pylotylo/UW-ENGINE2023-Acoustic-Beamforming-Device/README.md

# UW-ENGINE2023-Acoustic-Beamforming-Device
This is a repository for the UW ENGINE 2023 Acoustic Beamforming Device team. Here we can share drafts of our Kicad files, and any other code related to the project.
