pylotylo/UW-ENGINE2023-Acoustic-Beamforming-Device/PCM1690 Breakout Board Draft 7/PCM1690 Breakout Board Draft 8.kicad_pcb

## KiCad design PCM1690 Breakout Board Draft 7/PCM1690 Breakout Board Draft 8.kicad_pcb (2023-03-06)

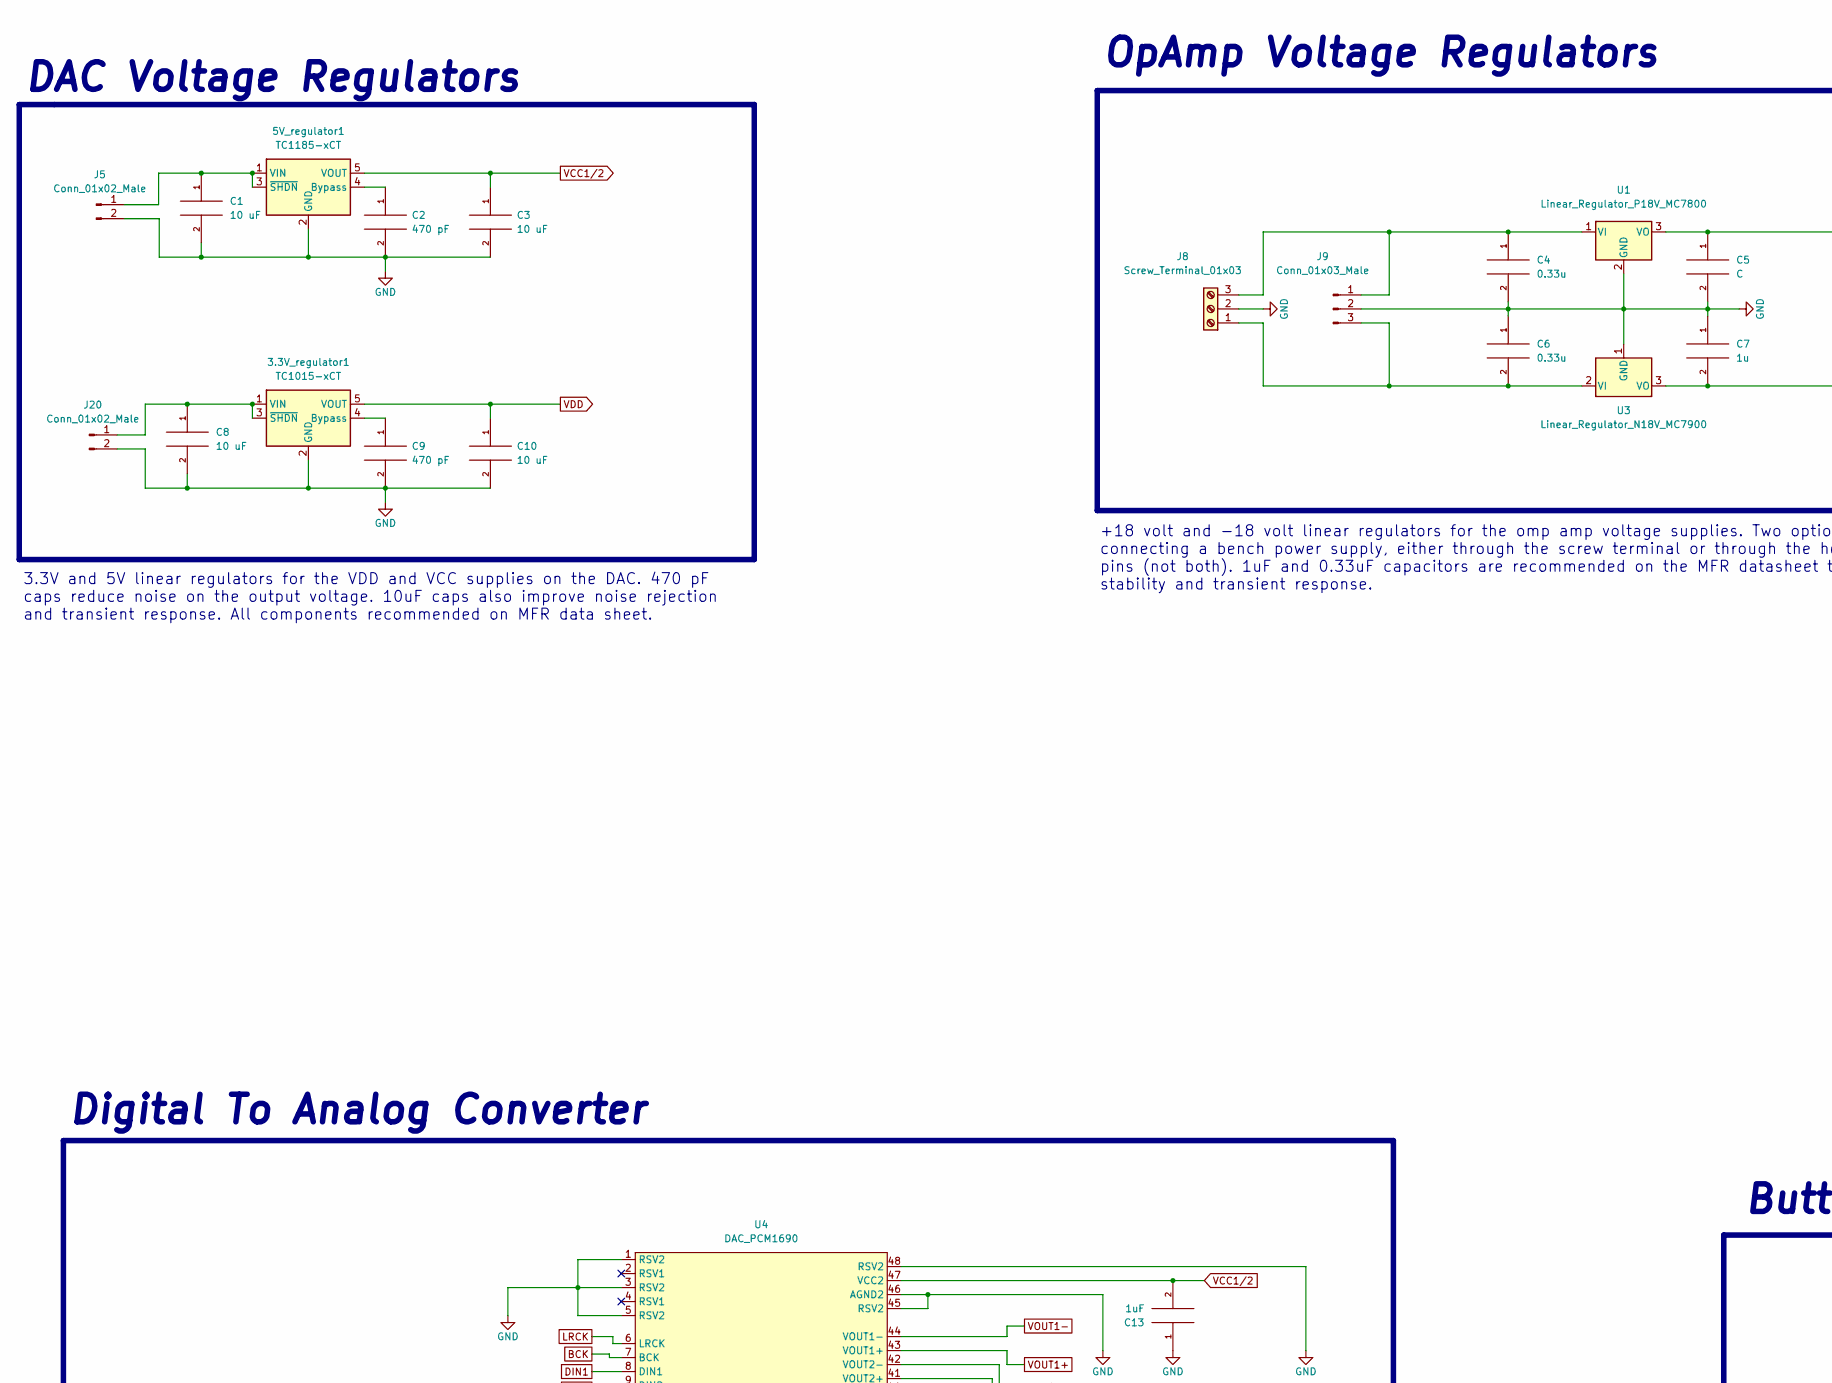
[picture p2: schematic PCM1690 Breakout Board Draft 8.kicad_sch, part in row 1, column 1]

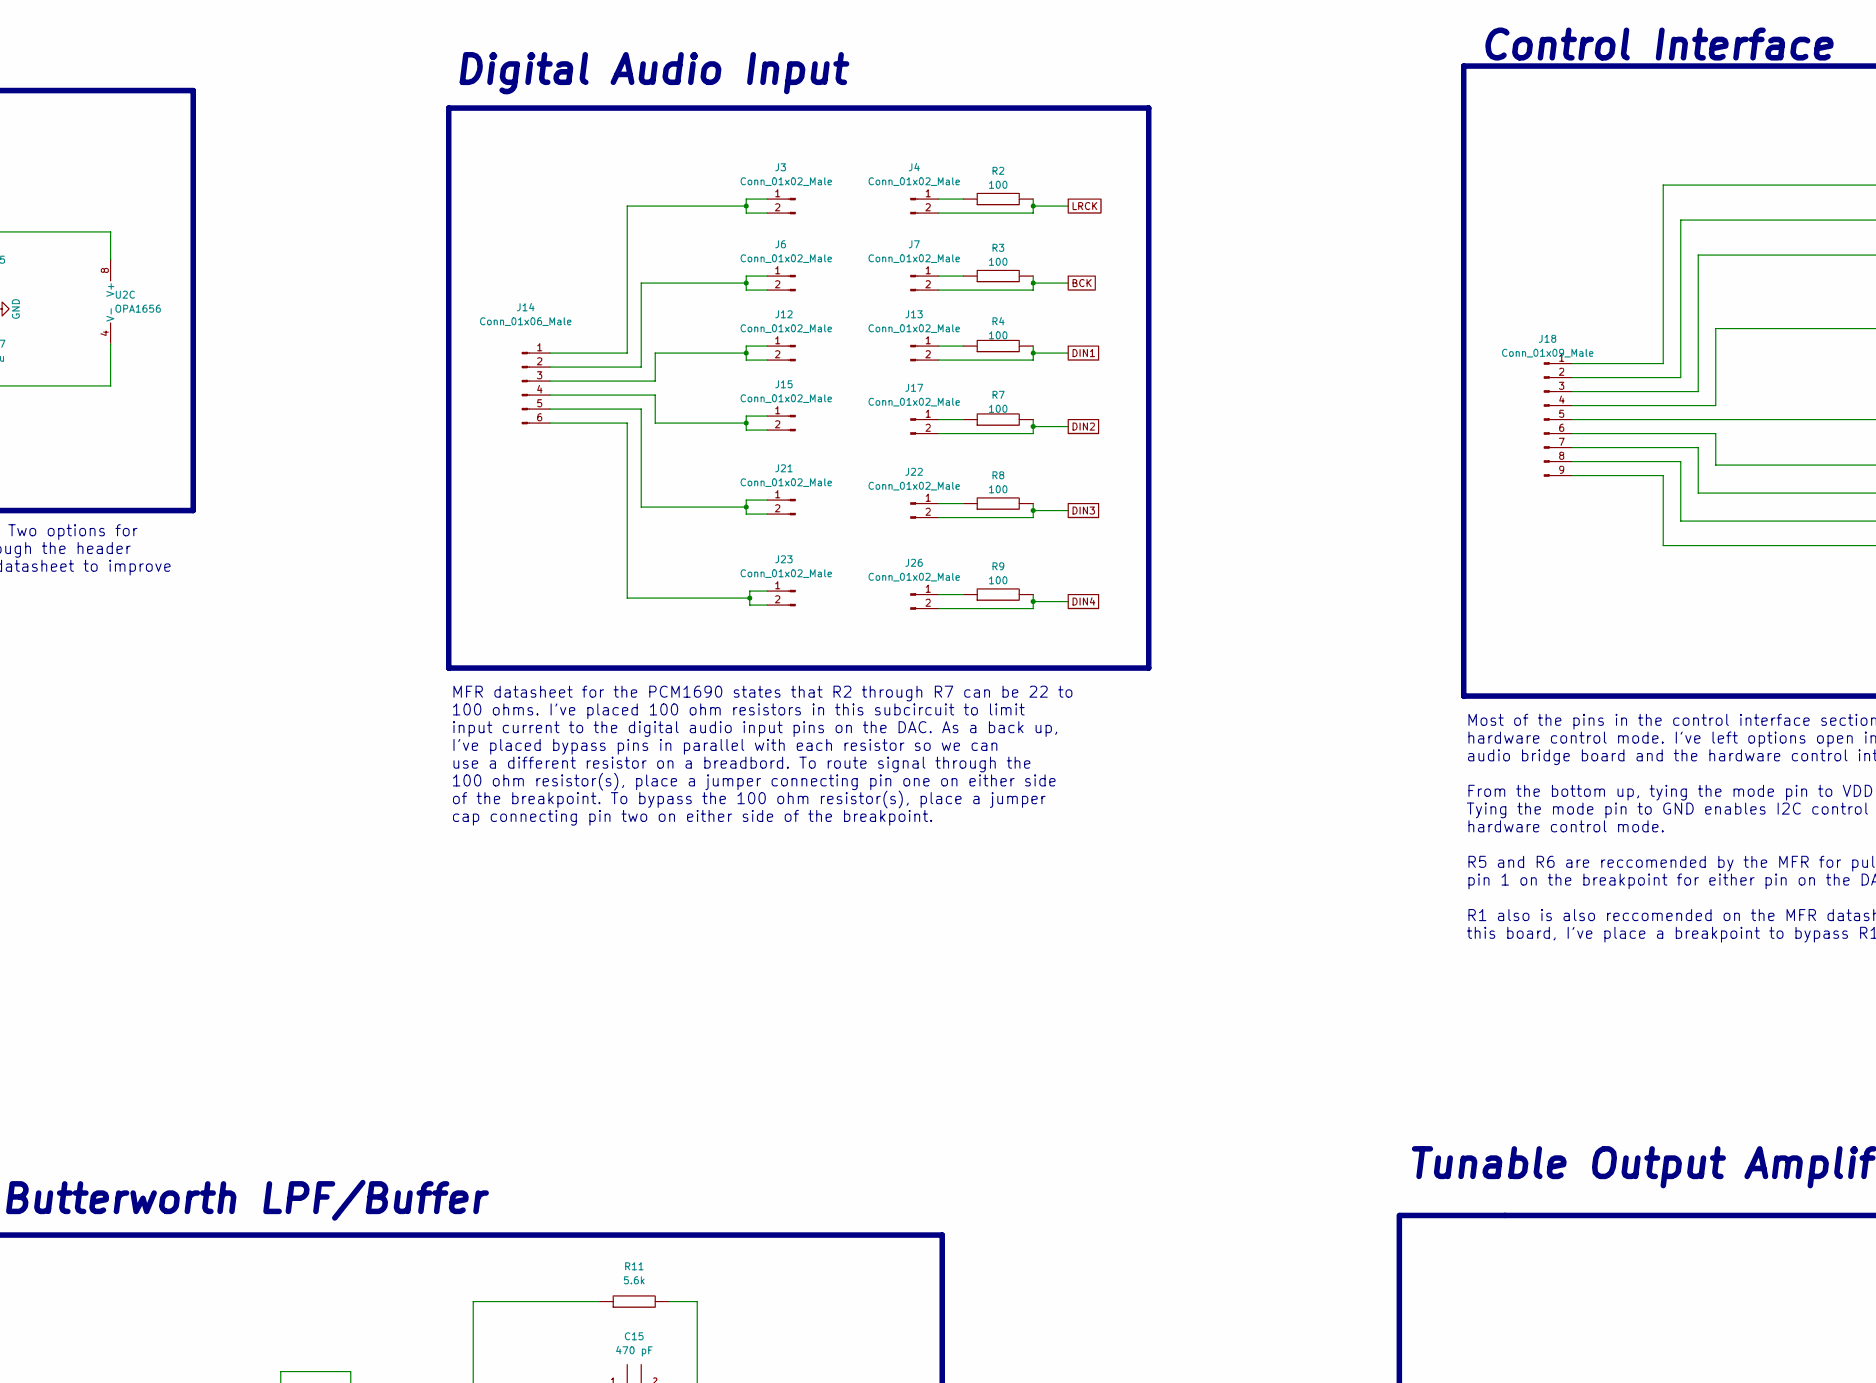
[picture p3: schematic PCM1690 Breakout Board Draft 8.kicad_sch, part in row 1, column 2]

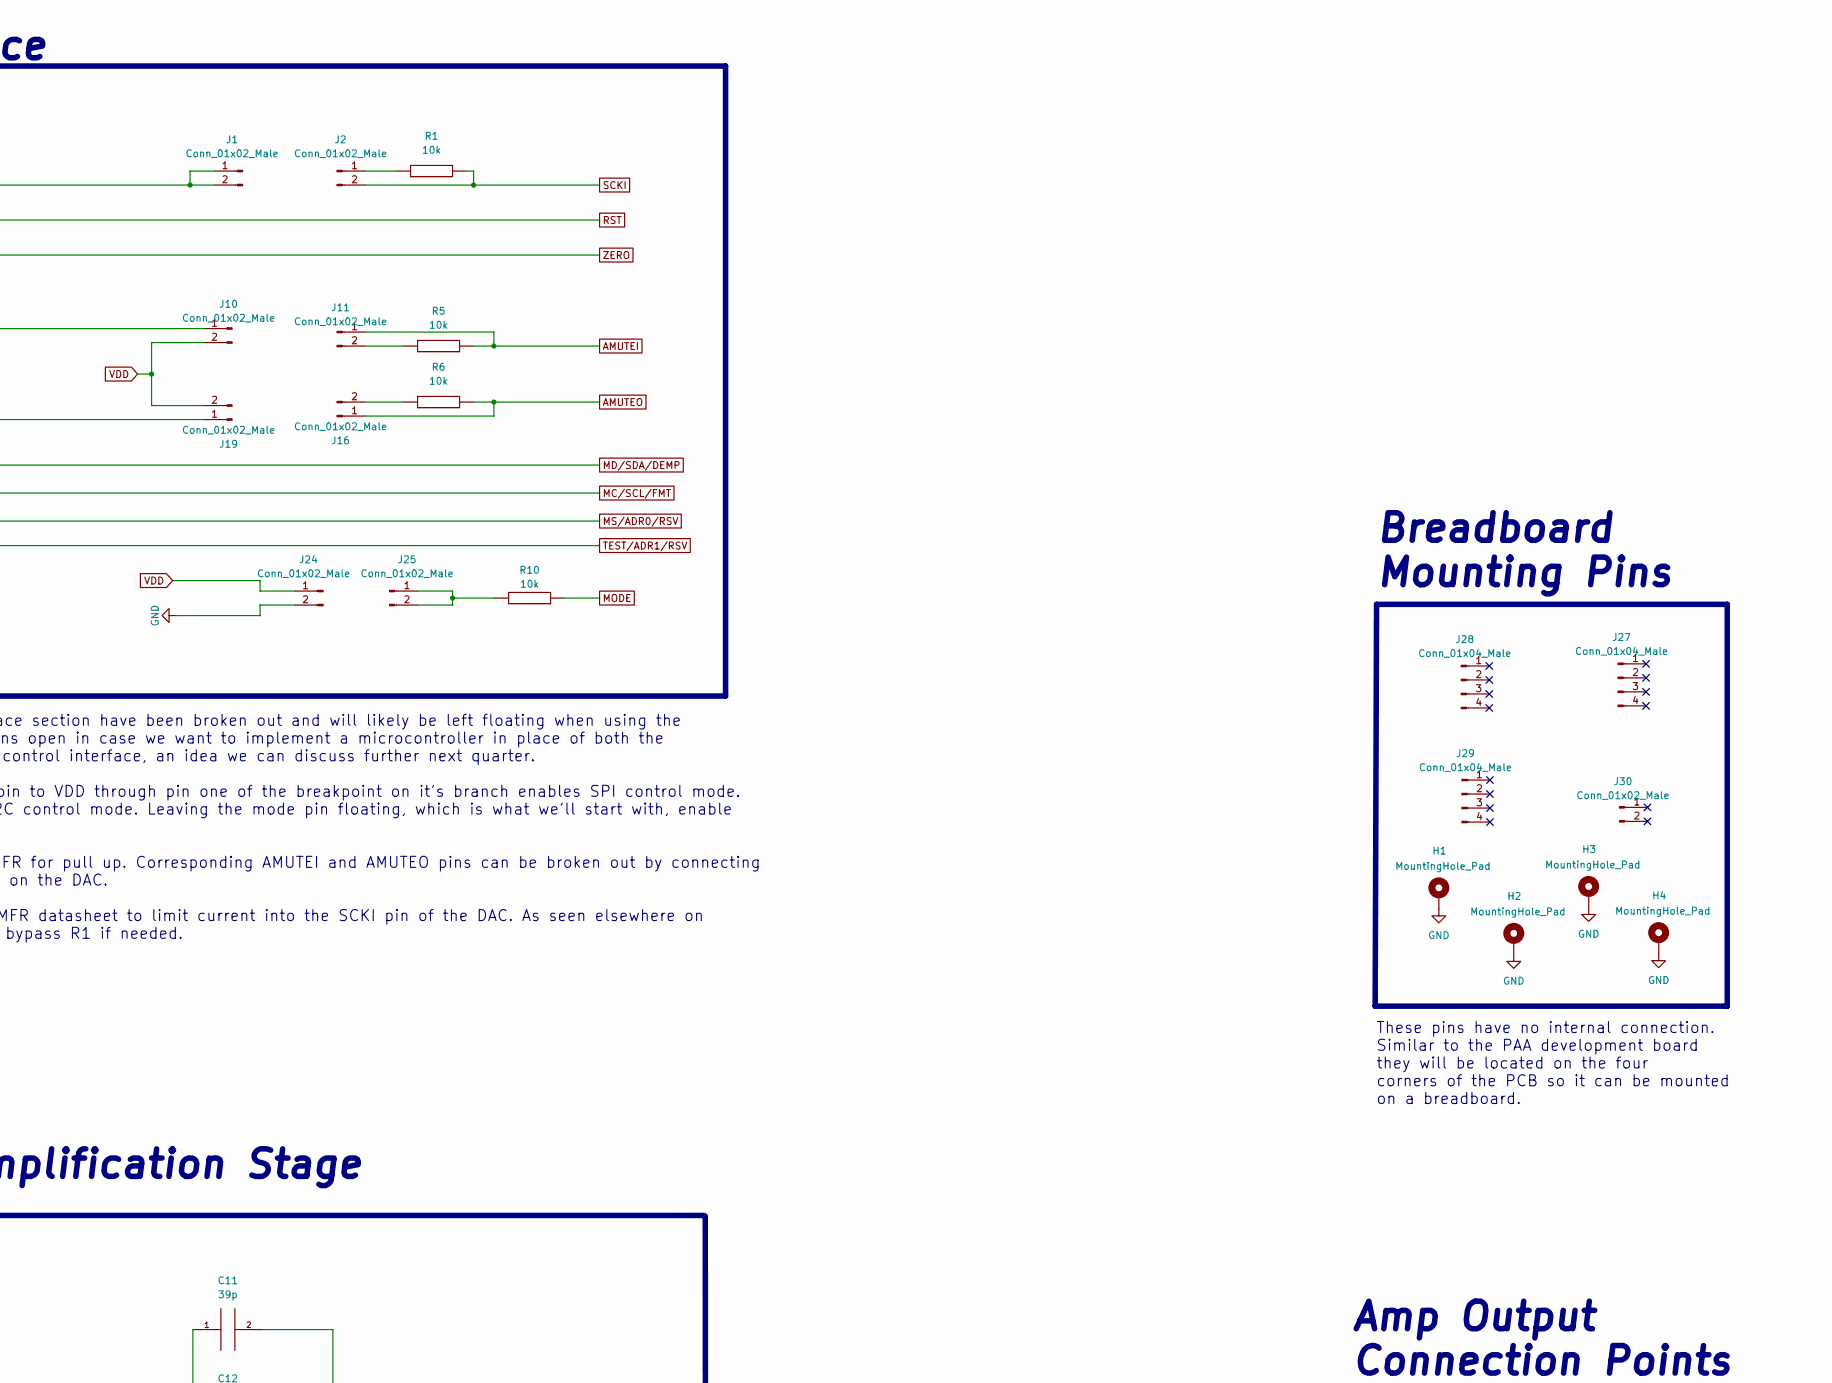
[picture p4: schematic PCM1690 Breakout Board Draft 8.kicad_sch, part in row 1, column 3]

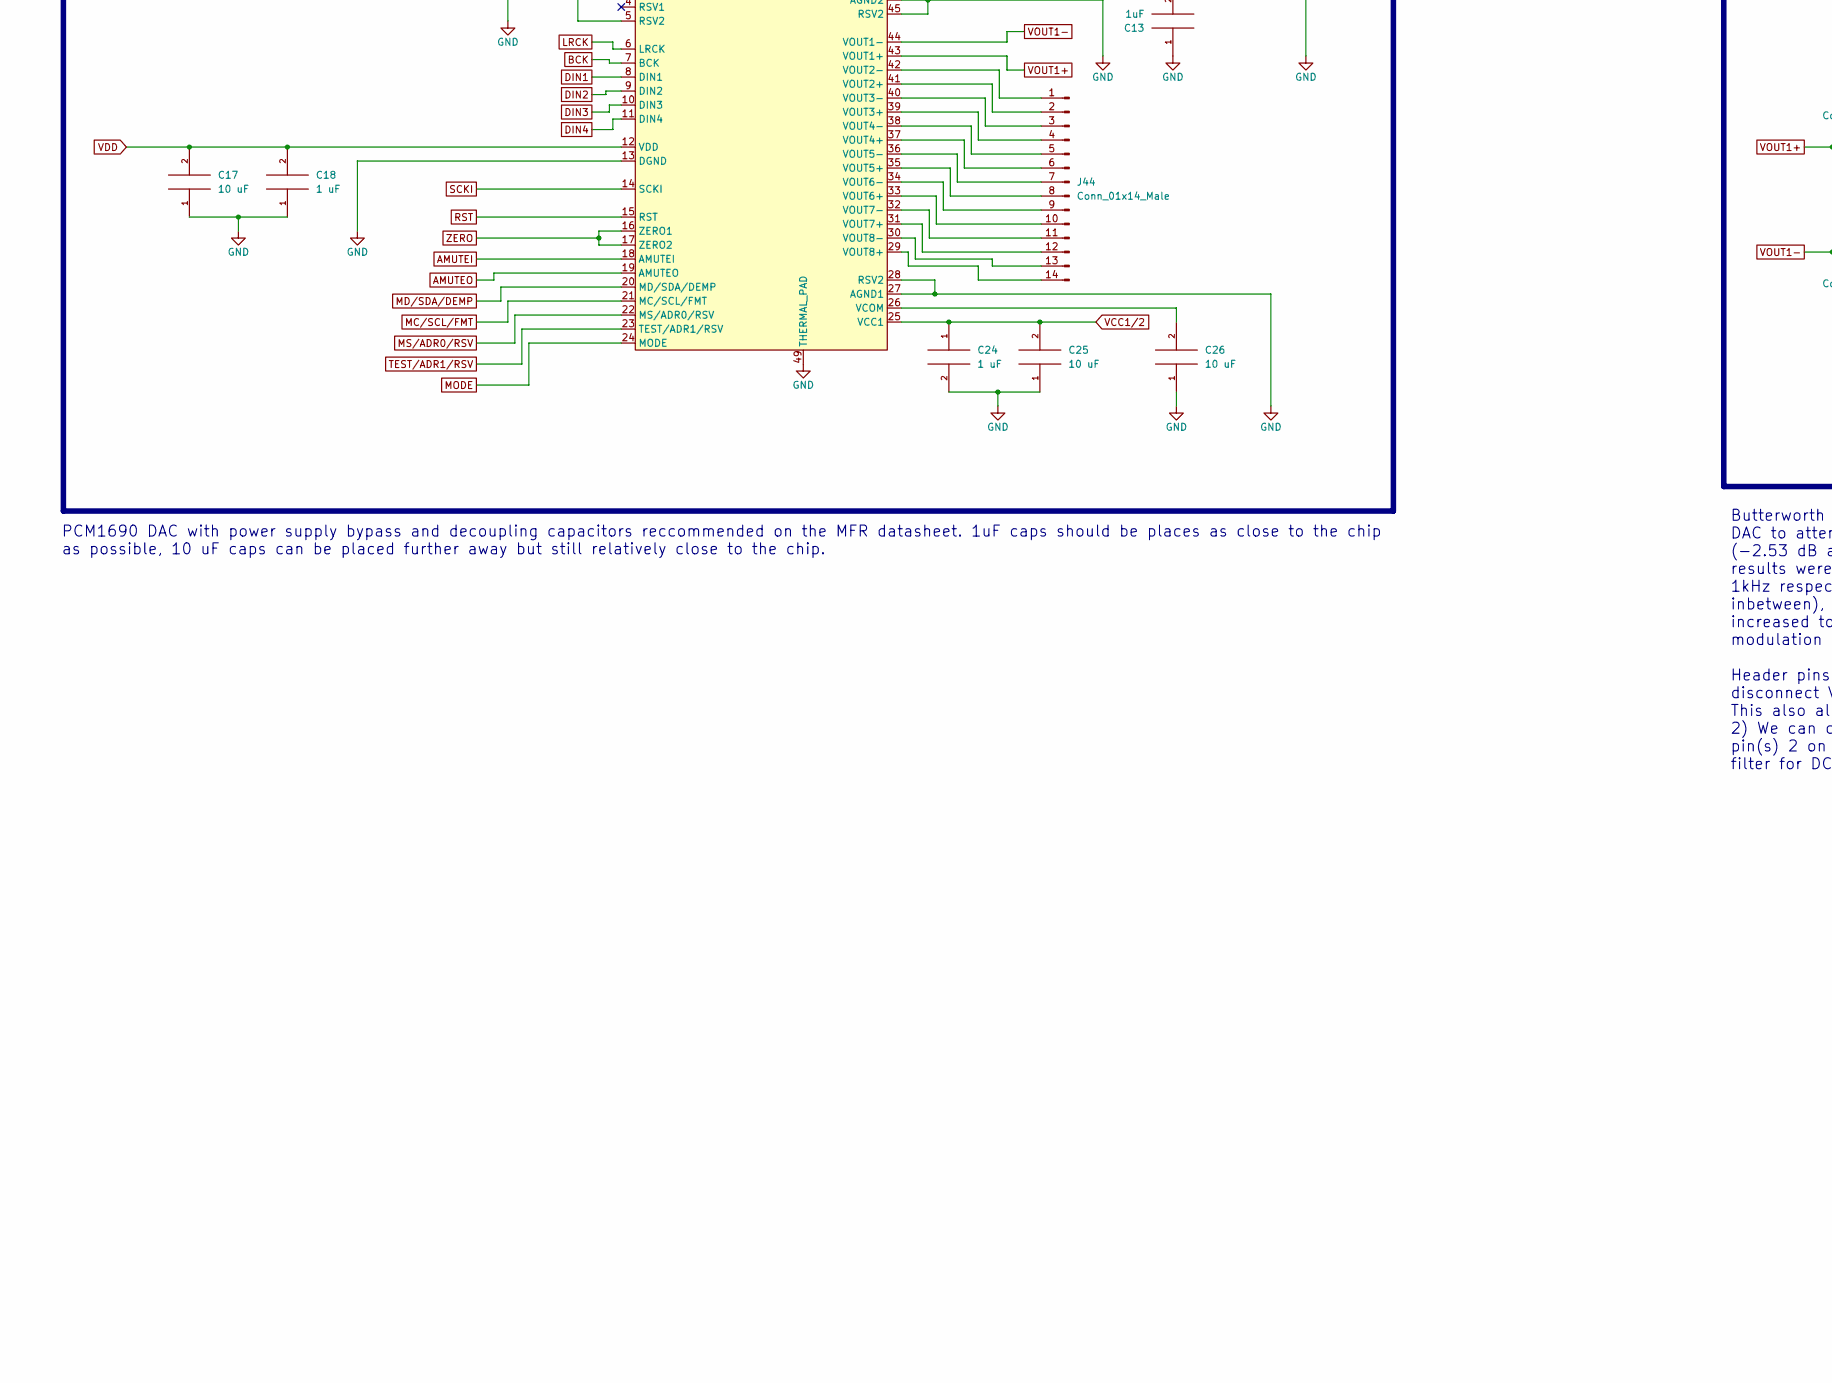
[picture p5: schematic PCM1690 Breakout Board Draft 8.kicad_sch, part in row 2, column 1]

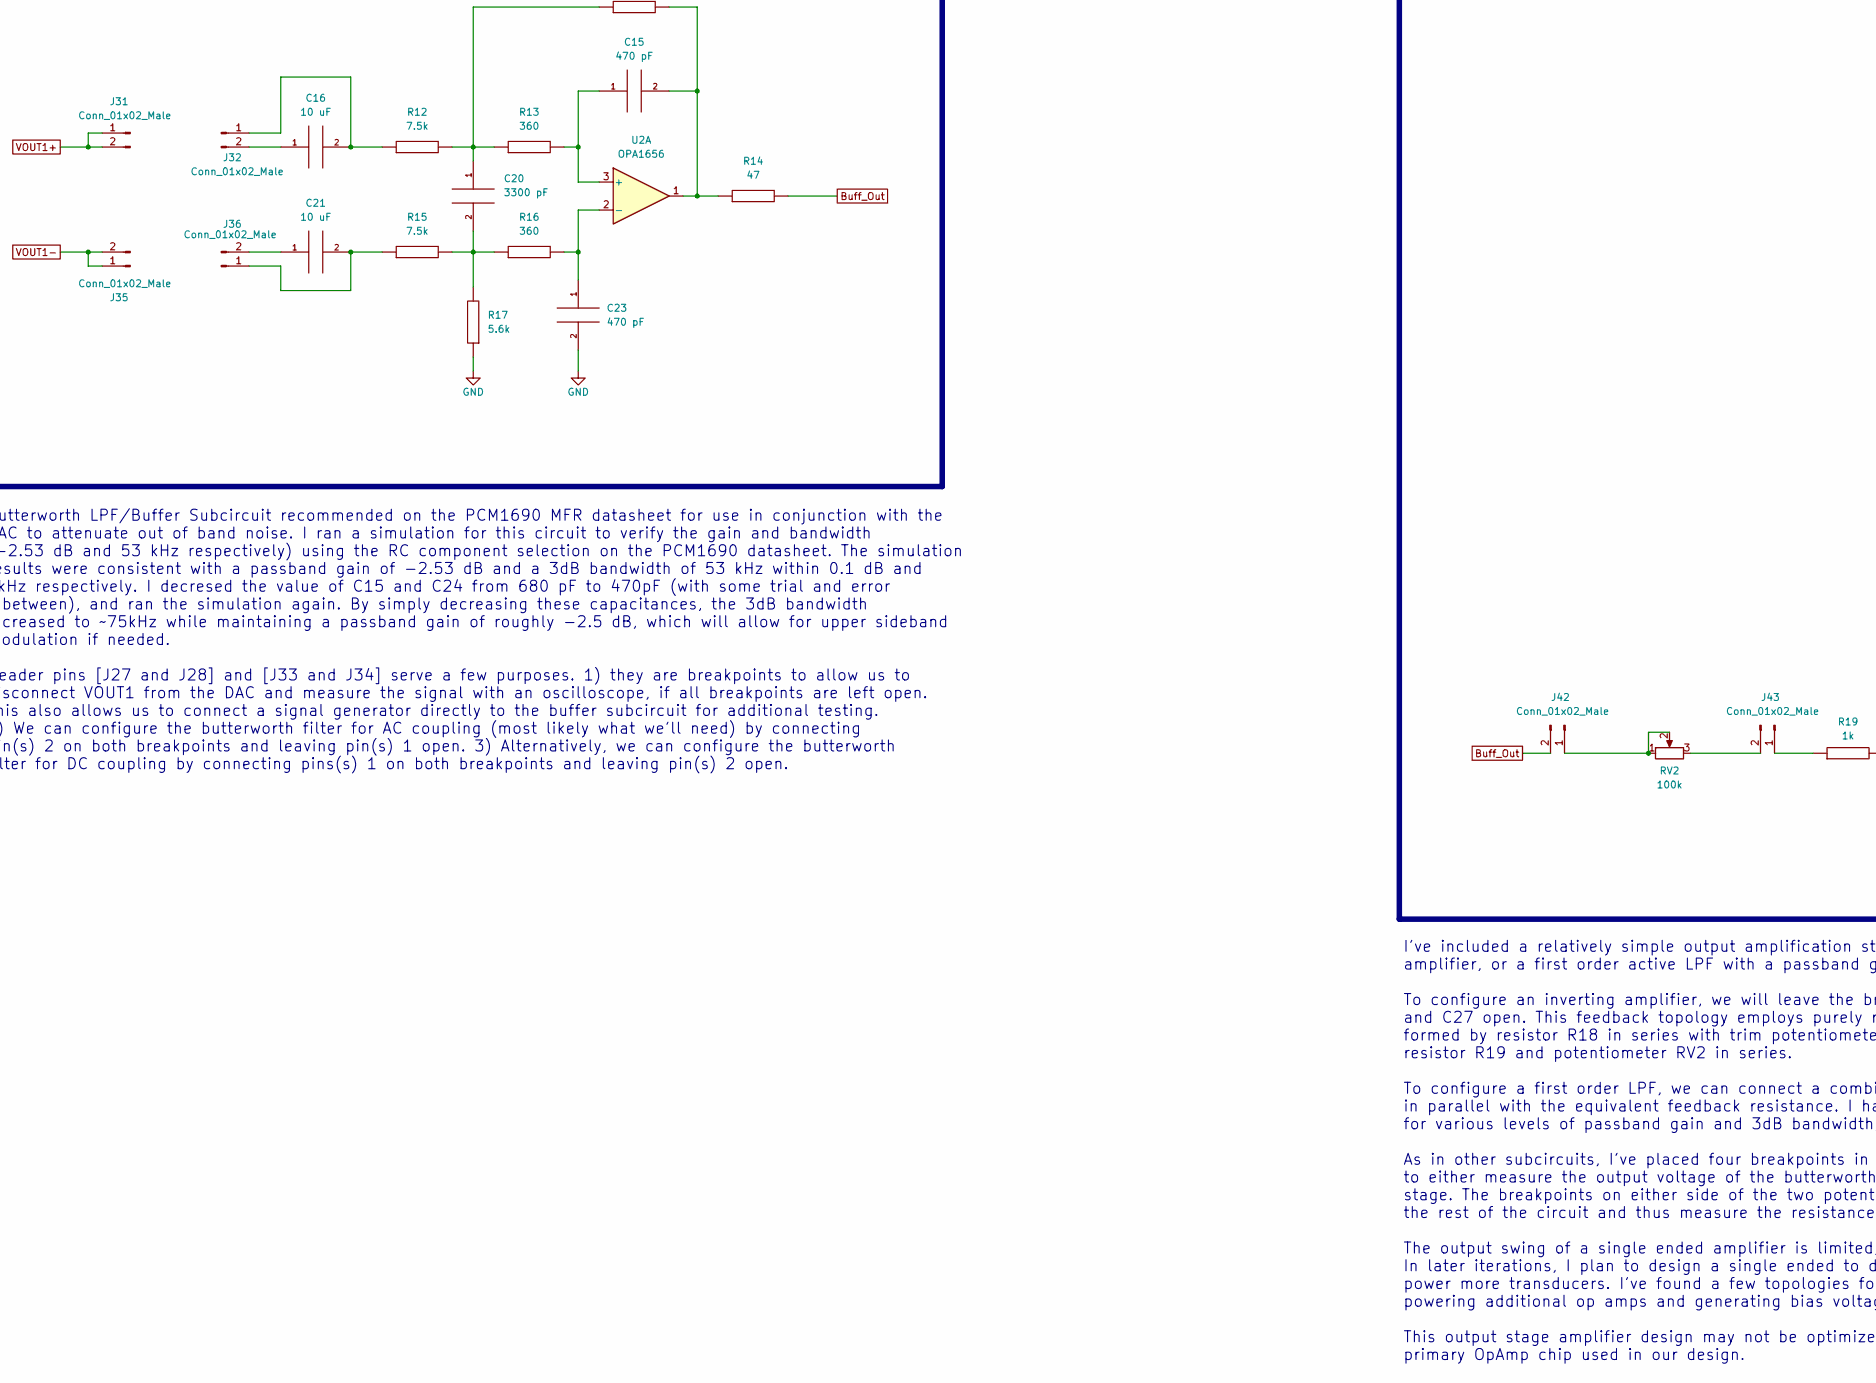
[picture p6: schematic PCM1690 Breakout Board Draft 8.kicad_sch, part in row 2, column 2]

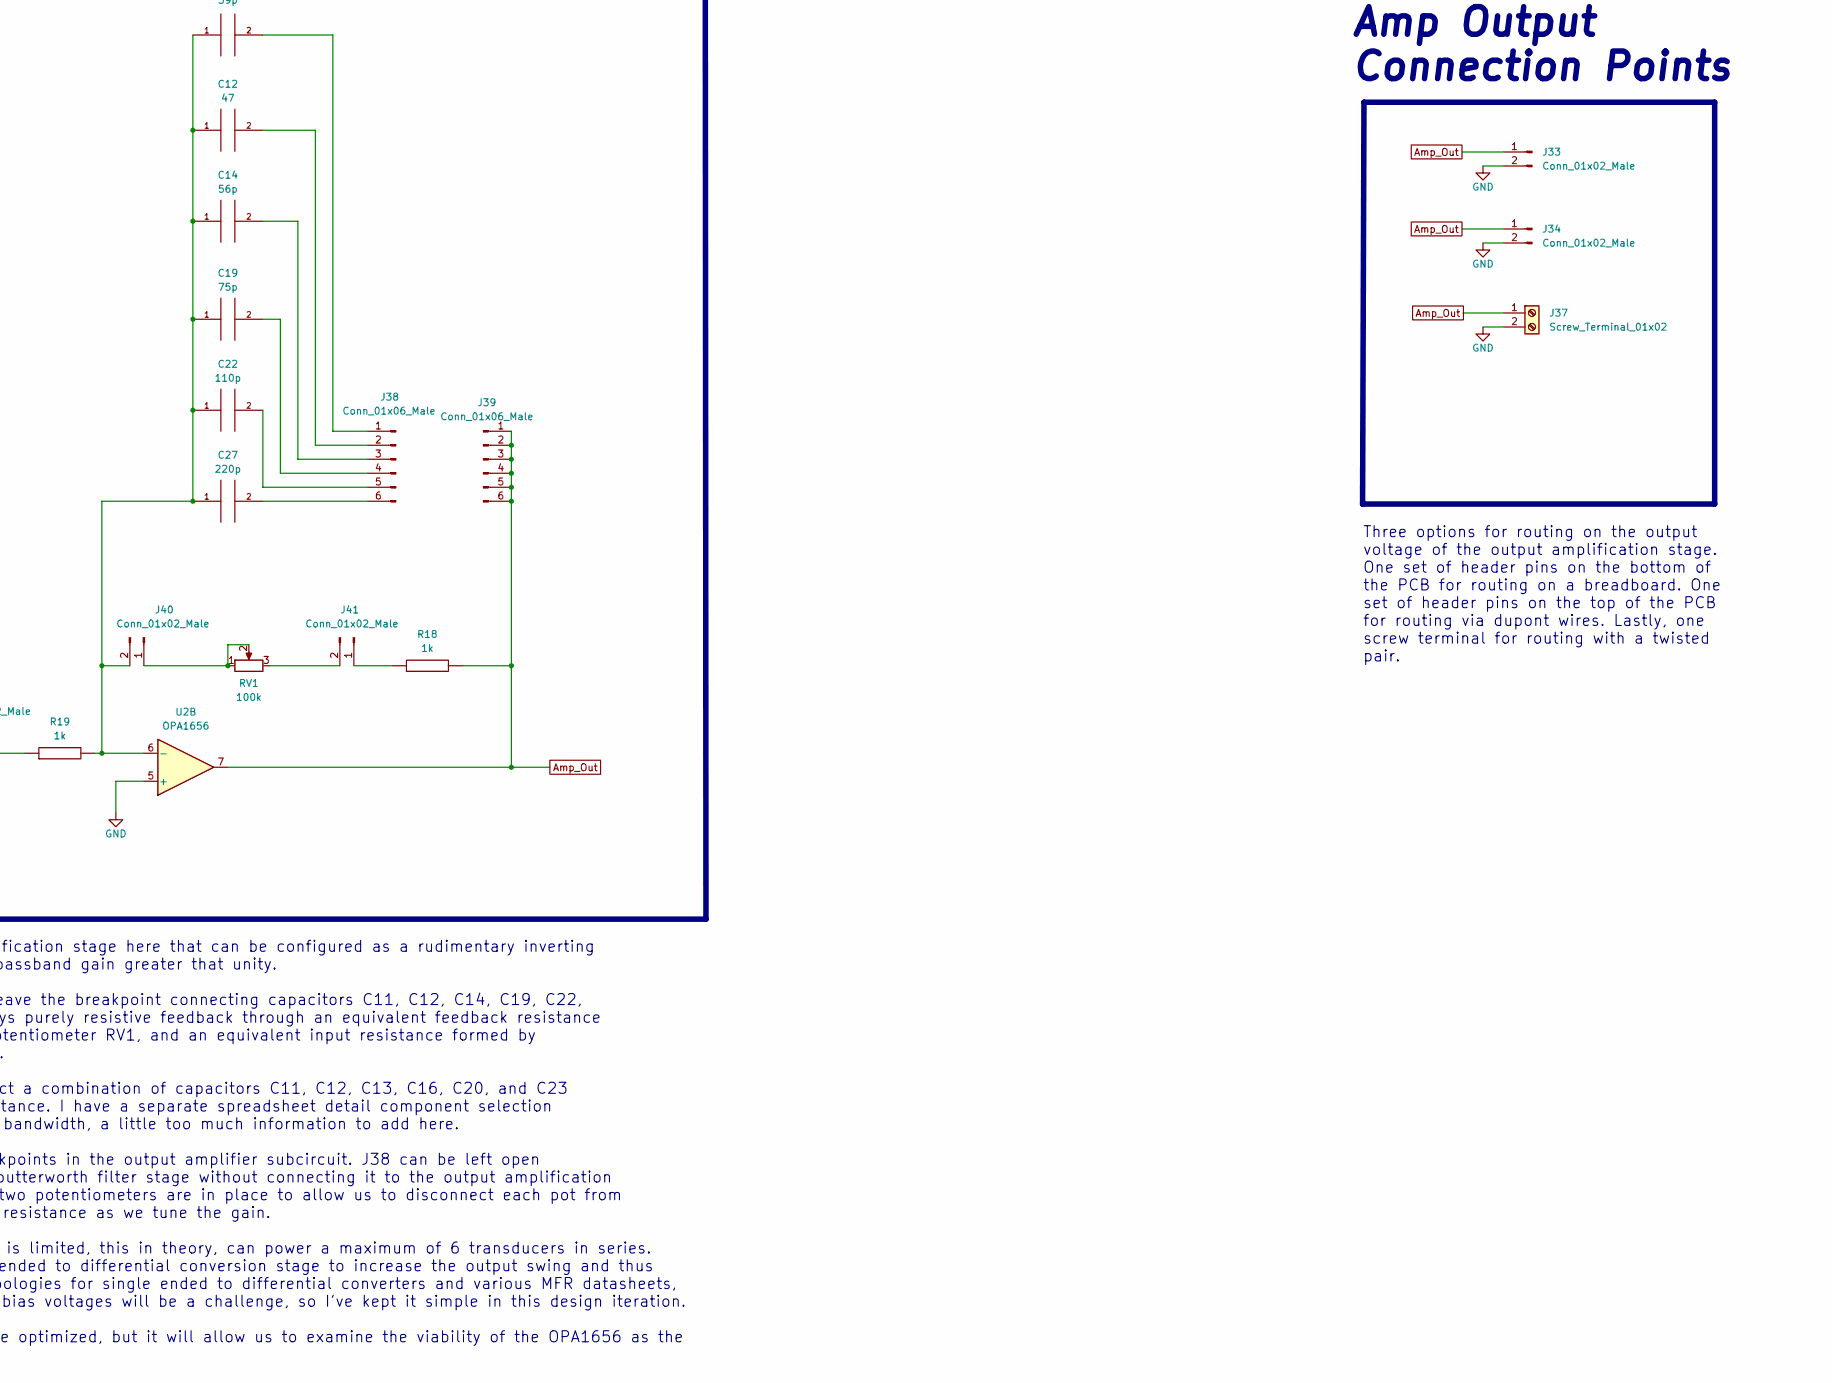
[picture p7: schematic PCM1690 Breakout Board Draft 8.kicad_sch, part in row 2, column 3]

Parts:
3.3V_regulator1: TC1015-xCT; SOT-23-5
5V_regulator1: TC1185-xCT; SOT-23-5
C1, C3, C8, C10, C16, C17, C21, C25, C26: 10 uF; C_0603_1608Metric
C2, C9, C15, C23: 470 pF; C_0603_1608Metric
C4, C6: 0.33u; C_0603_1608Metric
C5: C; C_0603_1608Metric
C7: 1u; C_0603_1608Metric
C11: 39p; C_0603_1608Metric
C12: 47; C_0603_1608Metric
C13: 1uF; C_0603_1608Metric
C14: 56p; C_0603_1608Metric
C18, C24: 1 uF; C_0603_1608Metric
C19: 75p; C_0603_1608Metric
C20: 3300 pF; C_0603_1608Metric
C22: 110p; C_0603_1608Metric
C27: 220p; C_0603_1608Metric
H1, H2, H3, H4: MountingHole_Pad; MountingHole_4.3mm_M4_Pad_Via
J1, J2, J3, J4, J5, J6, J7, J10, J11, J12, J13, J15, J16, J17, J19, J20, J21, J22, J23, J24, J25, J26, J30, J31, J32, J33, J34, J35, J36, J40, J41, J42, J43: Conn_01x02_Male; PinHeader_1x02_P2.54mm_Vertical_NoCourtyard
J8: Screw_Terminal_01x03; TerminalBlock_bornier-3_P5.08mm
J9: Conn_01x03_Male; PinHeader_1x03_P2.54mm_Vertical_NoCourtyard
J14, J38, J39: Conn_01x06_Male; PinHeader_1x06_P2.54mm_Vertical_NoCourtyard
J18: Conn_01x09_Male; PinHeader_1x09_P2.54mm_Vertical_No_Courtyard
J27, J28, J29: Conn_01x04_Male; PinHeader_1x04_P2.54mm_Vertical_NoCourtyard
J37: Screw_Terminal_01x02; TerminalBlock_bornier-2_P5.08mm
J44: Conn_01x14_Male; PinHeader_1x14_P2.54mm_Vertical_NoCourtyard
R1, R5, R6, R10: 10k; R_0603_1608Metric_Pad0.98x0.95mm_HandSolder
R2, R3, R4, R7, R8, R9: 100; R_0603_1608Metric_Pad0.98x0.95mm_HandSolder
R11, R17: 5.6k; R_0603_1608Metric_Pad0.98x0.95mm_HandSolder
R12, R15: 7.5k; R_0603_1608Metric_Pad0.98x0.95mm_HandSolder
R13, R16: 360; R_0603_1608Metric_Pad0.98x0.95mm_HandSolder
R14: 47; R_0603_1608Metric_Pad0.98x0.95mm_HandSolder
R18, R19: 1k; R_0603_1608Metric_Pad0.98x0.95mm_HandSolder
RV1, RV2: 100k; Potentiometer_Bourns_3296W_Vertical
U1: Linear_Regulator_P18V_MC7800; TO-220-3_Vertical
U2: OPA1656; OPA1656_SOIC-8_3.9x5.4mm_P1.27mm
U3: Linear_Regulator_N18V_MC7900; TO-220-3_Vertical
U4: DAC_PCM1690; PCM1690_No_Courtyard_Thermal

Connections:
AMUTEI: J11.1, R5.2, U4.18 (AMUTEI)
AMUTEO: J16.1, R6.2, U4.19 (AMUTEO)
Amp_Out: J33.1, J34.1, J37.1, J39.1, J39.2, J39.3, J39.4, J39.5, J39.6, R18.2, U2.7
BCK: J7.2, R3.2, U4.7 (BCK)
Buff_Out: J42.2, R14.2
DIN1: J13.2, R4.2, U4.8 (DIN1)
DIN2: J17.2, R7.2, U4.9 (DIN2)
DIN3: J22.2, R8.2, U4.10 (DIN3)
DIN4: J26.2, R9.2, U4.11 (DIN4)
GND: 3.3V_regulator1.2 (GND), 5V_regulator1.2 (GND), C1.2, C2.2, C3.2, C4.2, C5.2, C6.1, C7.1, C8.2, C9.2, C10.2, C13.1, C17.1, C18.1, C23.2, C24.2, C25.1, C26.1, H1.1, H2.1, H3.1, H4.1, J5.2, J8.2, J9.2, J20.2, J24.2, J33.2, J34.2, J37.2, R17.1, U1.2 (GND), U2.5 (+), U3.1 (GND), U4.1 (RSV2), U4.3 (RSV2), U4.5 (RSV2), U4.13 (DGND), U4.27 (AGND1), U4.28 (RSV2), U4.45 (RSV2), U4.46 (AGND2), U4.48 (RSV2), U4.49 (THERMAL_PAD)
LRCK: J4.2, R2.2, U4.6 (LRCK)
MC/SCL/FMT: J18.7, U4.21 (MC/SCL/FMT)
MD/SDA/DEMP: J18.6, U4.20 (MD/SDA/DEMP)
MODE: R10.1, U4.24 (MODE)
MS/ADR0/RSV: J18.8, U4.22 (MS/ADR0/RSV)
unnamed: 3.3V_regulator1.1 (VIN), 3.3V_regulator1.3 (~SHDN), C8.1, J20.1
unnamed: 3.3V_regulator1.4 (Bypass), C9.1
unnamed: 5V_regulator1.1 (VIN), 5V_regulator1.3 (~SHDN), C1.1, J5.1
unnamed: 5V_regulator1.4 (Bypass), C2.1
unnamed: C4.1, J8.3, J9.1, U1.1 (VI)
unnamed: C5.1, U1.3 (VO), U2.8 (V+)
unnamed: C6.2, J8.1, J9.3, U3.2 (VI)
unnamed: C7.2, U2.4 (V-), U3.3 (VO)
unnamed: C11.1, C12.1, C14.1, C19.1, C22.1, C27.1, J40.2, R19.2, U2.6 (-)
unnamed: C11.2, J38.1
unnamed: C12.2, J38.2
unnamed: C14.2, J38.3
unnamed: C15.1, R13.2, U2.3 (+)
unnamed: C15.2, R11.2, R14.1, U2.1
unnamed: C16.1, J32.2
unnamed: C16.2, J32.1, R12.1
unnamed: C19.2, J38.4
unnamed: C20.1, R11.1, R12.2, R13.1
unnamed: C20.2, R15.2, R16.1, R17.2
unnamed: C21.1, J36.2
unnamed: C21.2, J36.1, R15.1
unnamed: C22.2, J38.5
unnamed: C23.1, R16.2, U2.2 (-)
unnamed: C26.2, U4.26 (VCOM)
unnamed: C27.2, J38.6
unnamed: J1.1, J1.2, J18.1
unnamed: J2.1, R1.1
unnamed: J4.1, R2.1
unnamed: J7.1, R3.1
unnamed: J10.1, J18.4
unnamed: J11.2, R5.1
unnamed: J12.1, J12.2, J14.3
unnamed: J13.1, R4.1
unnamed: J3.1, J3.2, J14.1
unnamed: J6.1, J6.2, J14.2
unnamed: J14.4, J15.1, J15.2
unnamed: J14.5, J21.1, J21.2
unnamed: J14.6, J23.1, J23.2
unnamed: J16.2, R6.1
unnamed: J17.1, R7.1
unnamed: J18.5, J19.1
unnamed: J22.1, R8.1
unnamed: J25.1, J25.2, R10.2
unnamed: J26.1, R9.1
unnamed: J40.1, RV1.1, RV1.2
unnamed: J41.1, R18.1
unnamed: J41.2, RV1.3
unnamed: J42.1, RV2.1, RV2.2
unnamed: J43.1, R19.1
unnamed: J43.2, RV2.3
unnamed: J44.1, U4.42 (VOUT2-)
unnamed: J44.2, U4.41 (VOUT2+)
unnamed: J44.3, U4.40 (VOUT3-)
unnamed: J44.4, U4.39 (VOUT3+)
unnamed: J44.5, U4.38 (VOUT4-)
unnamed: J44.6, U4.37 (VOUT4+)
unnamed: J44.7, U4.36 (VOUT5-)
unnamed: J44.8, U4.35 (VOUT5+)
unnamed: J44.9, U4.34 (VOUT6-)
unnamed: J44.10, U4.33 (VOUT6+)
unnamed: J44.11, U4.32 (VOUT7-)
unnamed: J44.12, U4.31 (VOUT7+)
unnamed: J44.13, U4.30 (VOUT8-)
unnamed: J44.14, U4.29 (VOUT8+)
RST: J18.2, U4.15 (RST)
SCKI: J2.2, R1.2, U4.14 (SCKI)
TEST/ADR1/RSV: J18.9, U4.23 (TEST/ADR1/RSV)
VCC1/2: 5V_regulator1.5 (VOUT), C3.1, C13.2, C24.1, C25.2, U4.25 (VCC1), U4.47 (VCC2)
VDD: 3.3V_regulator1.5 (VOUT), C10.1, C17.2, C18.2, J10.2, J19.2, J24.1, U4.12 (VDD)
VOUT1+: J31.1, J31.2, U4.43 (VOUT1+)
VOUT1-: J35.1, J35.2, U4.44 (VOUT1-)
ZERO: J18.3, U4.16 (ZERO1), U4.17 (ZERO2)

Notes on the sheet:
PCM1690 DAC with power supply bypass and decoupling capacitors reccommended on the MFR datasheet. 1uF caps should be places as close to the chip as possible, 10 uF caps can be placed further away but still relatively close to the chip.
Butterworth LPF/Buffer
MFR datasheet for the PCM1690 states that R2 through R7 can be 22 to 100 ohms. I've placed 100 ohm resistors in this subcircuit to limit input current to the digital audio input pins on the DAC. As a back up, I've placed bypass pins in parallel with each resistor so we can use a different resistor 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
Tunable Output Amplification Stage
DAC Voltage Regulators
OpAmp Voltage Regulators
Digital Audio Input
I've included a relatively simple output amplification stage here that can be configured as a rudimentary inverting amplifier, or a first order active LPF with a passband gain greater that unity. To configure an inverting amplifier, we will leave the breakpoint connecting capacitors C11, C12, C14, 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
Breadboard Mounting Pins
Most of the pins in the control interface section have been broken out and will likely be left floating when using the hardware control mode. I've left options open in case we want to implement a microcontroller in place of both the audio bridge board and the hardware control interface, an idea we 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
3.3V and 5V linear regulators for the VDD and VCC supplies on the DAC. 470 pF caps reduce noise on the output voltage. 10uF caps also improve noise rejection and transient response. All components recommended on MFR data sheet.
Digital To Analog Converter
These pins have no internal connection. Similar to the PAA development board they will be located on the four corners of the PCB so it can be mounted on a breadboard.
Amp Output Connection Points
Control Interface
Three options for routing on the output voltage of the output amplification stage. One set of header pins on the bottom of the PCB for routing on a breadboard. One set of header pins on the top of the PCB for routing via dupont wires. Lastly, one screw terminal for routing with a twisted pair.
Butterworth LPF/Buffer Subcircuit recommended on the PCM1690 MFR datasheet for use in conjunction with the DAC to attenuate out of band noise. I ran a simulation for this circuit to verify the gain and bandwidth (-2.53 dB and 53 kHz respectively) using the RC component selection on the PCM1690 data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
+18 volt and -18 volt linear regulators for the omp amp voltage supplies. Two options for connecting a bench power supply, either through the screw terminal or through the header pins (not both). 1uF and 0.33uF capacitors are recommended on the MFR datasheet to improve stability and transient respo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

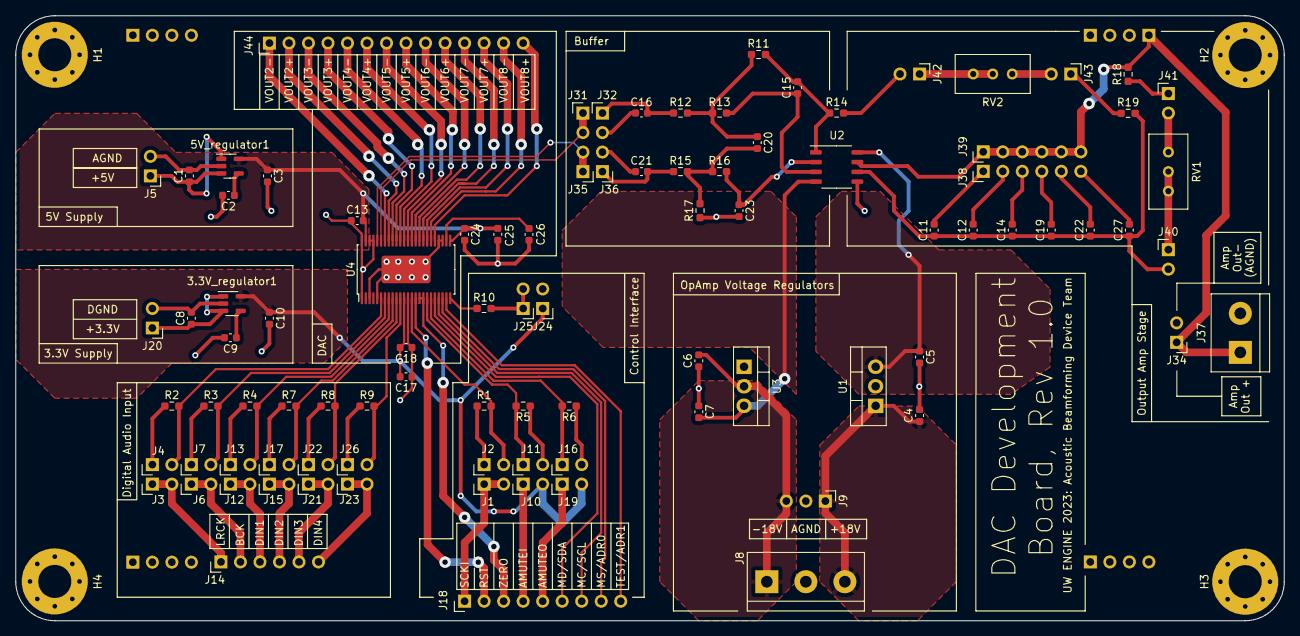
[picture p8: board PCM1690 Breakout Board Draft 8.kicad_pcb from above]

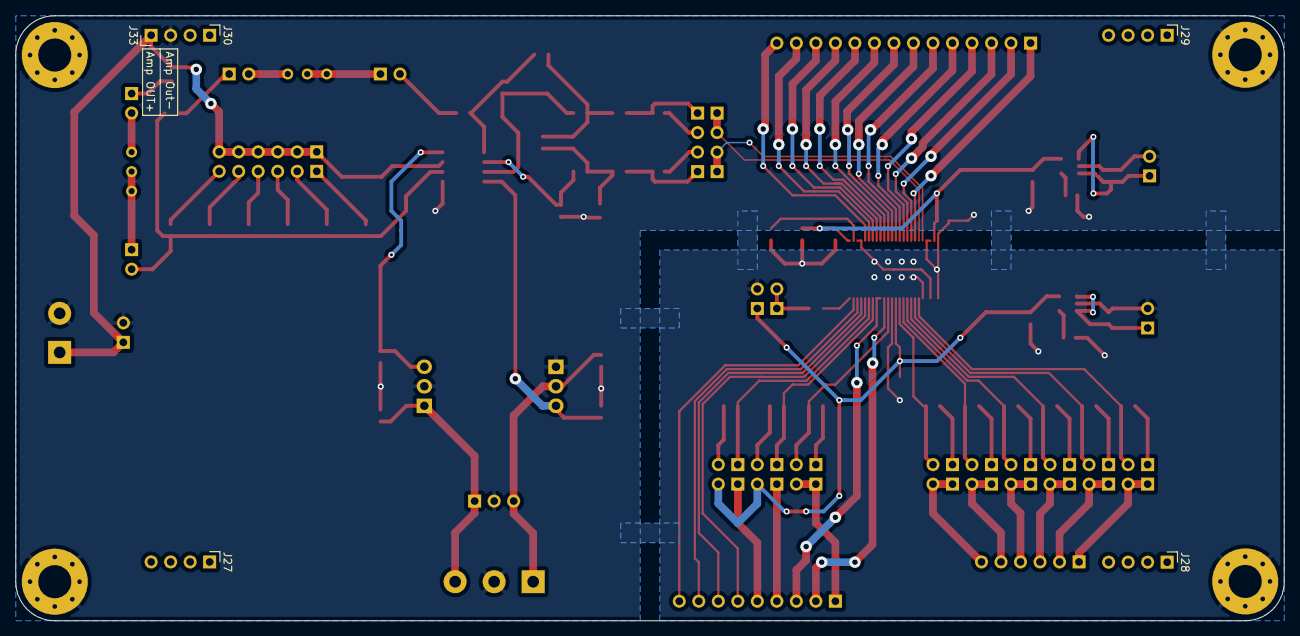
[picture p9: board PCM1690 Breakout Board Draft 8.kicad_pcb from below]

Board: 2 copper layers, 165.1 x 78.7 mm, 102 parts (5 on the bottom side), 87 nets.
