pylotylo/UW-ENGINE2023-Acoustic-Beamforming-Device/(commit log)

2023-02-16 Add files via upload
    This is my first draft of the PCM1690 DAC breakout board. There are a couple notable issues. 1) I used the incorrect footprint, we could update this with the new PCM1690 footprint if we want to order a PCB with no onboard passives. 2) I did not make any copper pours in this draft, draft 3 includes copper ground pours.
    [DAC_Breakout_Board_Draft1.kicad_pcb]
2023-02-16 Add files via upload
    This is an incomplete draft, I was experimenting with routing options. I've uploaded this here in case anyone wants to use this draft as a reference.
    [DAC_Breakoutboard_Draft2.kicad_pcb]
2023-02-16 Add files via upload
    Draft 3 includes some onboard power-supply decoupling capacitors. Based on figure 41, on page 37 of the PCM1690 datasheet, I placed capacitors C1-C3 in this layout. C4-C6 are electrolytic capacitors, I left these off of this breakout board with the intent to connect C4-C6 to the appropriate pins on a breadboard.
    There are a couple issues to fix in this draft. 1) The filled zone for the copper ground pour is not showing up when I try to display it. I followed on online tutorial for adding copper pours, I'm not sure what went wrong. 2) there are a few DRC warnings titled "Track Has Unconnected End" I'm not sure if this is because the tracks are routed from the pins on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
    [DAC_Breakoutboard_Draft3.kicad_pcb]
